savethechicken/foot-pedal/README.md

# USB Foot Pedal

A 3D-printable USB foot pedal powered by a Raspberry Pi Pico. It plugs in like a keyboard and sends whatever keys you choose, from a single key like **F13** to combos like **Ctrl+Shift+F13**. Change the keys any time with the **Pedal Config** app, with no code editing.

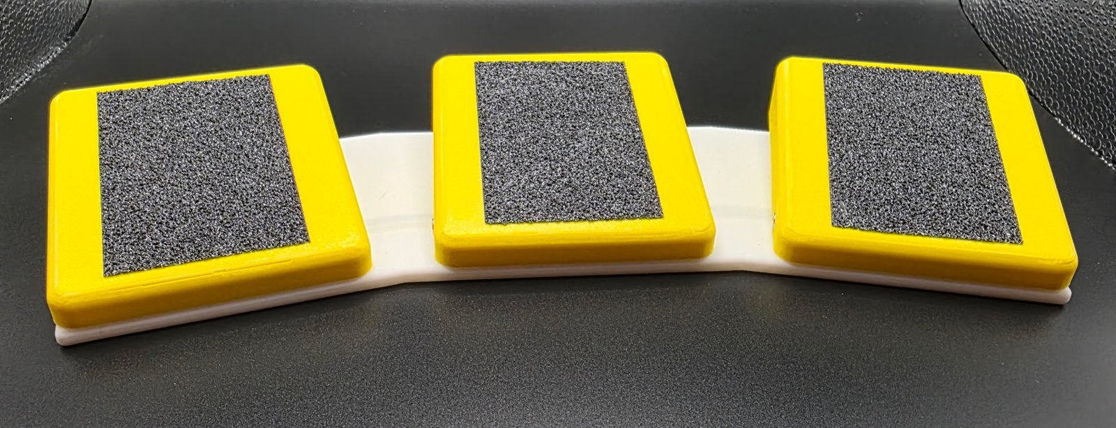
[picture p1: images/finished-front.jpg]
Finished three-pedal unit


- **Three-pedal version** (single-pedal version coming soon)
- **No supports needed.** Every printed part prints without supports.
- **Works on any computer** as a standard USB keyboard. The app is only needed to change keys.
- Mechanical key switch inside each pedal, with real metal springs for a solid feel

Inspired by the [USB Foot Switch](https://makerworld.com/en/models/2042179-usb-foot-switch#profileId-2203328) on MakerWorld. This is a complete redesign, not a remix, so **parts are not interchangeable** with the original.

---

## What's in this repo

| Folder | Contents |
|---|---|
| [`3d-print/`](3d-print) | Printable parts (`.3mf`) |
| [`firmware/`](firmware) | `boot.py` and `code.py` for the Pico (CircuitPython) |
| [`app/`](app) | Pedal Config app source (`pedal_config.py`) |
| [Releases](../../releases) | **Pedal Config.exe**, ready to run on Windows |
| [`docs/build-notes.md`](docs/build-notes.md) | My full build log: spring testing, print settings, code history |

---

## Materials

| Item | Single | Three | Notes |
|---|---|---|---|
| Raspberry Pi Pico 1 or 2 | 1 | 1 | |
| Cherry MX–style mechanical key switch | 1 | 3 | I used **Cherry MX Blue**: "clicky" switches that give a satisfying audible click with each press, so you know the pedal registered. Any MX-style switch fits. Pick a quieter type (Red, Brown) if the click would bother you or others nearby, like on a stream or call |
| Compression spring, 3/8" × 3/4" (≈9.5 × 19.1 mm) | 2 | 6 | From the [Harbor Freight 200-piece assorted spring set](https://www.harborfreight.com/200-piece-assorted-spring-set-67562.html), which includes 10 of this size. 7/32" × 11/16" and 3/8" × 5/8" from the same set also work |
| M3 heat-set inserts | 2 | 6 | Recommended. Screws alone also work (see Assembly) |
| M3 × 4 screws | 2 | 6 | M3 × 5 or M3 × 6 also work but are harder to tighten in the tight gap |
| M2 self-tapping screws | up to 4 | up to 4 | Optional, to mount the Pico. Hot glue works too |
| 22 AWG wire | ✓ | ✓ | Any color |
| Wago 221 lever connectors (2-port) | – | 2 | For the shared ground. Soldering the grounds together works too |
| Superglue and/or hot glue | optional | optional | Holds wire runs and the Pico in place |

> **Why not printed springs?** I tested several printable spring designs. Results were hit and miss, and 3 out of 5 failed before they could be used. Cheap metal springs are much more reliable.

---

## Printing

| Setting | Value |
|---|---|
| Material | PLA or PETG (both tested) |
| Supports | **None** |
| Layer height | 0.20 mm |
| Wall loops | 2 |
| Infill | 15% |

| File | Qty (three pedal) |
|---|---|
| `3d-print/three-pedal/TripleBaseV1.3mf` | 1 |
| `3d-print/pedals/Pedal_CutOut.3mf` | 1, the far-left pedal over the Pico (cutout for the USB port) |
| `3d-print/pedals/Pedal_NoCutOut.3mf` | 2, the middle and right pedals |

**Ready-to-print projects** (everything on two plates, settings included):

| Printer | File | Base |
|---|---|---|
| 270 × 270 mm bed or larger (made on a Snapmaker U1) | `3d-print/3_Pedal_Foot_Pedal_270mm_one-piece.3mf` | One piece |
| Bambu P1S, X1C or A1 (256 mm bed) | `3d-print/3_Pedal_Foot_Pedal_P1S_split.3mf` | Two halves with alignment dowels; glue them together as described below |

⚠️ **The three-pedal base needs a bed of at least 270 × 270 mm** to print in one piece (I used a Snapmaker U1). The pedals fit any printer. Print settings for Bambu Lab printers are in the [build notes](docs/build-notes.md#print-settings).

### Smaller printer? Split the base

For Bambu 256 mm printers, the **pre-split project above** is already done for you. For other printers, Bambu Studio and Orca Slicer both have a **Cut** tool: split the base, print the halves, then glue or plastic-weld them back together.

- **Cut through the flat section between two pedal housings,** not through a housing, the pivot posts, the screw holes or the wire channel.
- **Add alignment connectors when cutting.** The Cut tool's **Dowel** or **Plug** options help the halves line up straight, so the pedals sit level.
- **Test-fit the dowels first.** If they're tight, raise the Cut tool's connector tolerance slightly (often 0.1–0.2 mm).
- **Join with** superglue (CA), plastic cement, or a plastic weld (a soldering iron melting filament into the seam). Let it fully cure before assembly, since the base takes your foot's weight on every press.

---

## Wiring

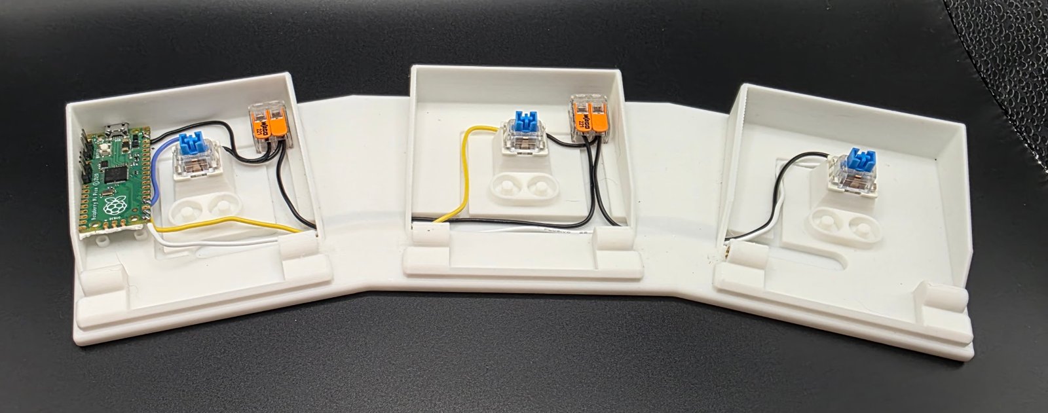
[picture p2: images/wiring-overview.jpg]
Wiring inside the three-pedal base


The Pico sits in the **far-left pedal** (as the unit sits on the floor in front of you), with its USB port facing out the side.

Each switch has two legs. One leg goes to its own Pico pin; the other goes to ground.

| Pedal | Pico pin | Physical pin # |
|---|---|---|
| Left | GP18 | 24 |
| Middle | GP17 | 22 |
| Right | GP16 | 21 |
| Ground (all switches) | GND | 38 (any GND pin works) |

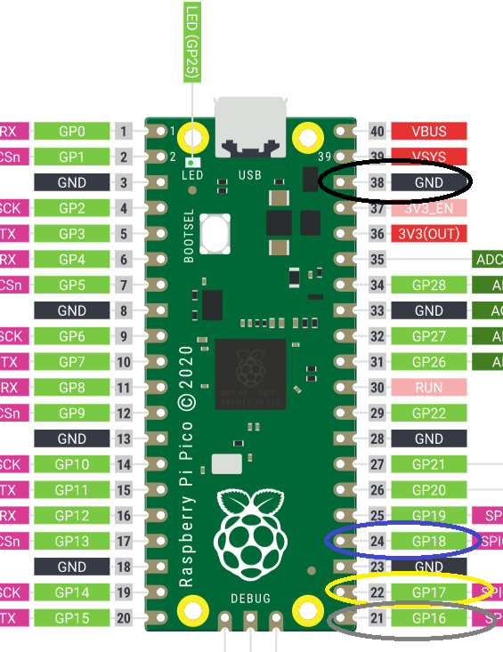
[picture p3: images/pico-pinout-pedal-pins.png]
Pico pinout with the pedal pins circled


*The pins used are circled. Note that the **GP** number (what the code uses) and the **physical pin number** (counted around the board) are different. Pinout diagram adapted from [Raspberry Pi Ltd](https://www.raspberrypi.com/documentation/microcontrollers/pico-series.html), CC BY-SA 4.0.*

> **Using different pins?** Any of the Pico's **GP** pins will work, but the firmware is set up for GP18, GP17 and GP16. If you wire to other pins, update the code to match, or those pedals won't respond:
>
> - **`code.py`:** the `PEDAL_PINS` line in the BUILD SETTINGS block, listed **left to right**. For example: `PEDAL_PINS = (board.GP2, board.GP3, board.GP4)`
> - **`boot.py`:** `SHOW_DRIVE_PIN`, the pedal you hold at plug-in to show the `CIRCUITPY` drive. It must be one of the pins in `PEDAL_PINS`.
>
> Ground can go to any **GND** pin.

**Ground:** Run one wire from a Pico **GND** pin to the switches. I daisy-chained it through two Wago connectors: the Pico's GND goes to Wago 1 in the left pedal, which feeds the left switch and continues to Wago 2 in the middle pedal, which feeds the middle and right switches. Where two thin wires share one Wago port, twist them together first. You can also solder the grounds together or use more than one of the Pico's GND pins.

No diodes are needed. Each pedal has its own pin, so there's no keyboard-matrix ghosting.

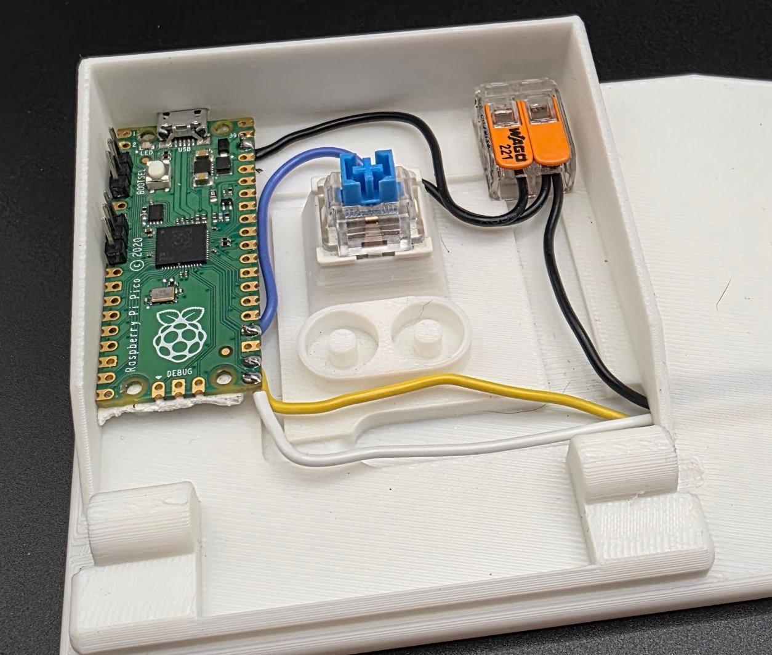
[picture p4: images/pico-closeup.jpg]
Pico close-up


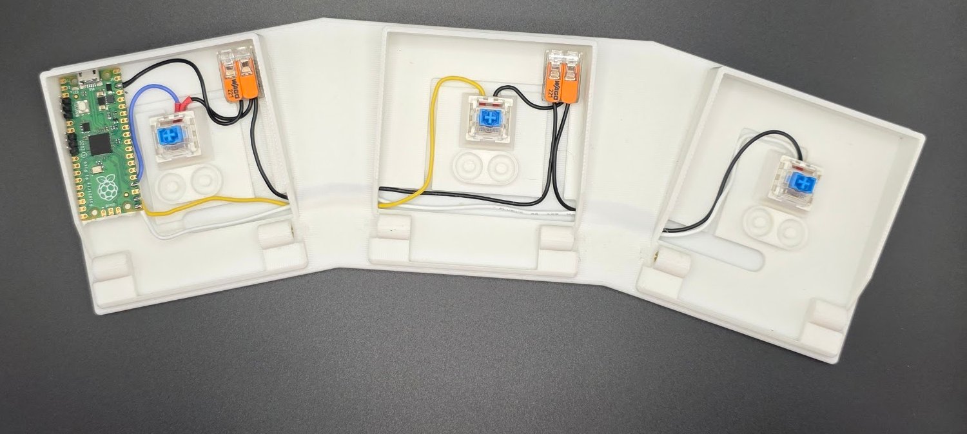
[picture p5: images/wiring-top.jpg]
Wiring, top view


---

## Assembly

1. **Heat-set inserts:** Install the M3 inserts. ⚠️ **Go slow.** There's no clear straight-on angle to the holes, but with patience they go in straight.

   > **Optional: skip the inserts.** In testing, the M3 screws also thread straight into the insert holes and hold the pedal in place with little to no play, while still letting it pivot correctly. Long-term durability without inserts hasn't been tested yet, so the inserts are still recommended. If you skip them and a pedal loosens over time, you can add inserts later.

2. **Pico:** Mount it with M2 self-tapping screws (the holes are sized at 1.8 mm), or hold it down with dots of hot glue at the corners. Keep glue off the USB port, the BOOTSEL button, and the solder joints.
3. **Switches and wiring:** Seat the switches, wire them as above, and glue the wire runs into their channels if you like.
4. **Springs:** Two per pedal, on the posts beside each switch.
5. **Pedals (three pedal):** Space between pedals is tight, so install in this order:
   1. **Middle pedal first:** with the outer pedals off, there's room for a driver on both screws.
   2. **Left and right pedals:** put in the **outside** screw first.
   3. **Inside screws:** reach into the gap with a small Allen wrench and turn a little at a time until flush on the inside.

   > ⚠️ **Don't over-tighten.** These screws are the pedal's hinge. Tighten them until they're snug, then check that the pedal still pivots freely and springs back up. If it binds, back the screws off slightly.

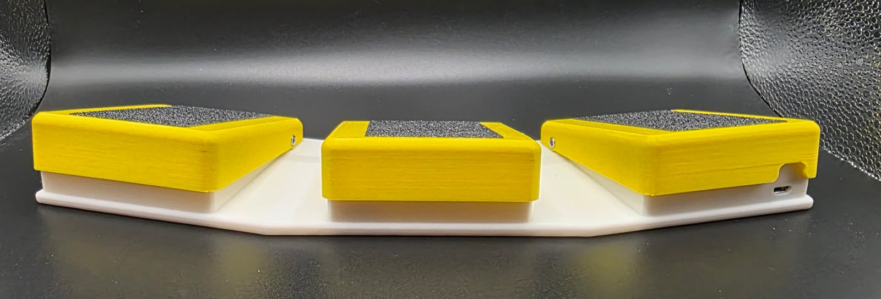
[picture p6: images/finished-side.jpg]
Side view


---

## Firmware

1. Install [CircuitPython](https://circuitpython.org/board/raspberry_pi_pico/) on the Pico ([Pico 2 page](https://circuitpython.org/board/raspberry_pi_pico2/)).
2. Download **`firmware.zip`** from [Releases](../../releases), unzip it, and copy everything inside (`boot.py`, `code.py`, and the `lib` folder) onto the `CIRCUITPY` drive. If the drive asks, replace the existing files. (The same files are in the [`firmware/`](firmware) folder of this repo.)
3. **Unplug and replug** the Pico.

When you're done, the drive should look like this:

```
CIRCUITPY/
├── boot.py
├── code.py
└── lib/
    └── adafruit_hid/
```

The only extra library needed, `adafruit_hid`, is included in `firmware/lib`. Everything else the code uses is built into CircuitPython. (If you prefer to get it yourself, it's in the official [CircuitPython library bundle](https://circuitpython.org/libraries).)

Default keys: **Left = F13, Middle = F14, Right = F15.** F13–F24 don't exist on normal keyboards, so they never clash with typing. Map them in Stream Deck, AutoHotkey, OBS, or any app that accepts hotkeys.

**Single pedal:** in `code.py`, swap the BUILD SETTINGS lines for the single-pedal ones (GP16), and in `boot.py` set `SHOW_DRIVE_PIN = board.GP16`.

### Editing the files later

`boot.py` hides the `CIRCUITPY` drive so the pedal acts like a plain keyboard. To show the drive, **hold the far-left pedal while plugging in.**

---

## Pedal Config app

Change each pedal's key or combo without touching code. Keys are saved on the Pico itself, so they stay set after unplugging and work on any computer.

### Option 1: download the `.exe` (Windows, easiest)

**No Python needed.** Everything the app needs is built into the `.exe`.

Download **Pedal Config.exe** from [Releases](../../releases) and run it. If Windows Defender warns about an unknown app, choose **More info → Run anyway**.

### Option 2: run from source (Windows, macOS, Linux)

**Requires Python 3.9 or newer** ([python.org](https://www.python.org/downloads/)). Use this option on macOS or Linux, or if you'd rather run the code directly.

```
py -m pip install pyserial
py app/pedal_config.py
```

On macOS or Linux, use `python3` in place of `py`.

### Using it

1. Plug in the pedal and open the app. It finds the pedal automatically.
2. For each pedal, tick any modifiers (Ctrl, Shift, Alt, Win) and pick a key.
3. Click **Save to Pedal**. The new keys work immediately.

Press a pedal and its dot in the app turns green, which is handy for checking your wiring.

<details>
<summary>How the app talks to the pedal</summary>

`boot.py` turns on a second USB serial port (`usb_cdc` data), separate from the normal CircuitPython console. The app sends one-line JSON commands over it:

| App sends | Pico replies |
|---|---|
| `{"cmd": "hello"}` | `{"ok": true, "device": "foot-pedal", "version": 1, "pedals": ["Left", "Middle", "Right"]}` |
| `{"cmd": "get"}` | `{"ok": true, "keys": [["F13"], ["F14"], ["F15"]]}` |
| `{"cmd": "set", "keys": [["CONTROL", "SHIFT", "F13"], ["F14"], ["A"]]}` | `{"ok": true, ...}` |

The Pico also sends `{"event": "press", "pedal": 0}` and `"release"` events. Keys are stored in the Pico's NVM (non-volatile memory) and checked against the `Keycode` list before saving, so a bad setting can't break the pedal.

</details>

### Building the `.exe` yourself

```
py -m pip install pyserial pyinstaller
py -m PyInstaller --onefile --windowed --name "Pedal Config" app/pedal_config.py
```

The `.exe` is also built automatically by GitHub Actions whenever a new release is published.

---

## Credits

- Original inspiration: [USB Foot Switch](https://makerworld.com/en/models/2042179-usb-foot-switch#profileId-2203328) on MakerWorld
- Designed by [savethechicken](https://github.com/savethechicken)

## License

This project uses two licenses:

| What | License | In short |
|---|---|---|
| **3D models, photos, docs** (`3d-print/`, `images/`, `docs/`, this README) | [CC BY-NC-SA 4.0](LICENSE-MODELS) | Download, print, and remix freely with credit. **No selling** the files or prints. Remixes must use the same license |
| **Firmware and app** (`firmware/`, `app/`) | [MIT](LICENSE-CODE) | Use, modify, and share freely. Keep the copyright notice |

Want to sell prints? [Open an issue](../../issues) and ask.

**Pico pinout diagram** (`images/pico-pinout-pedal-pins.png`): adapted from Raspberry Pi Ltd's Pico pinout, licensed CC BY-SA 4.0, not the project license.

**Included third-party library:** [`adafruit_hid`](https://github.com/adafruit/Adafruit_CircuitPython_HID) by Adafruit Industries, MIT License (see `firmware/lib/adafruit_hid/LICENSE`).
