savethechicken/foot-pedal/3d-print/3_Pedal_Foot_Pedal_P1S_split.3mf

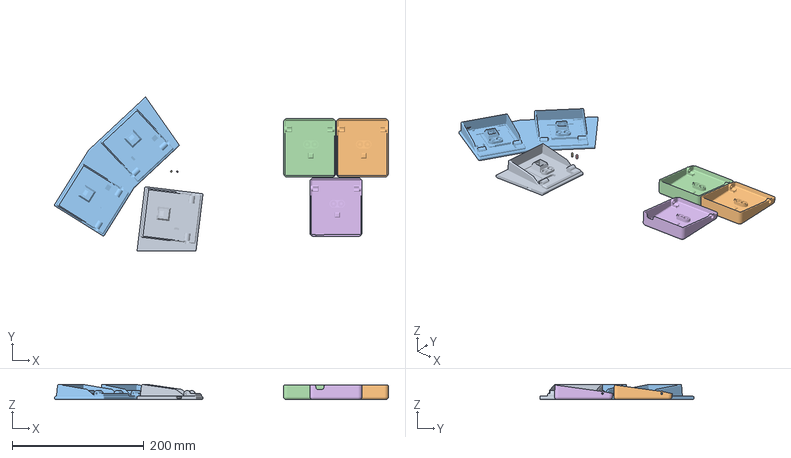
[picture p7: CAD file, 2026-10-11]
3d-print/3_Pedal_Foot_Pedal_P1S_split.3mf
507.0 x 233.9 x 22.8 mm
Base_Right
Pedal_NoCutOut x 2
Base_Left
Dowel-Connector-1
Pedal_CutOut
Dowel-Connector-2
