savethechicken/foot-pedal/3d-print/lids/Lid_NoCutOut.3mf

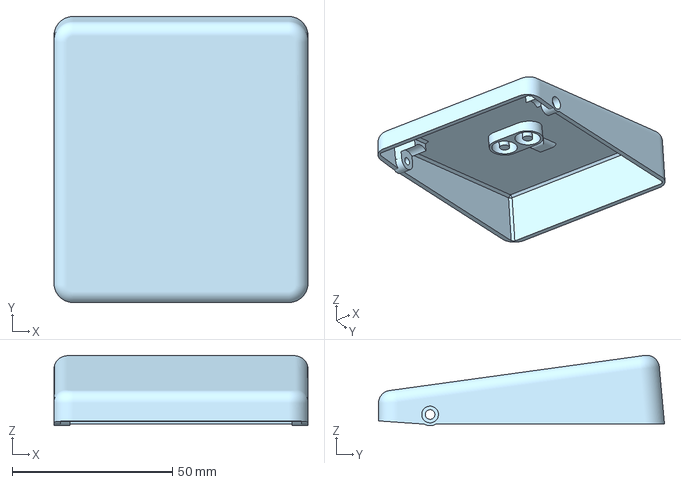
[picture p8: CAD file, 2026-10-10]
3d-print/lids/Lid_NoCutOut.3mf
79.2 x 89.2 x 22.0 mm
