savethechicken/foot-pedal/3d-print/three-pedal/TripleBaseV1.3mf

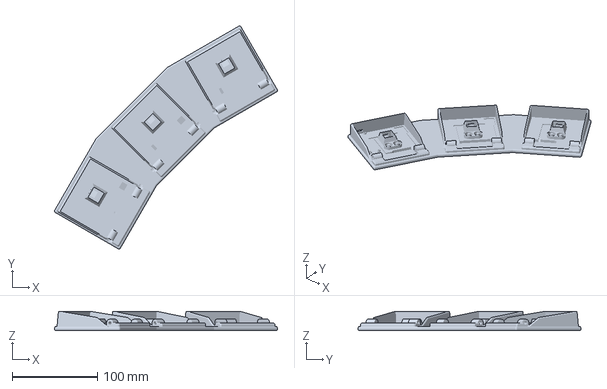
[picture p9: CAD file, 2026-10-10]
3d-print/three-pedal/TripleBaseV1.3mf
261.6 x 261.6 x 22.8 mm
