savethechicken/foot-pedal/(list of files, cad)

Other CAD files:
3d-print/pedals/Pedal_CutOut.3mf
