savethechicken/foot-pedal/(commit log)

2026-10-10 Initial release: three-pedal USB foot pedal
    3D print files, CircuitPython firmware with app-configurable keys,
    Pedal Config desktop app, and a GitHub Action that builds the .exe.
    Claude-Session: https://claude.ai/code/session_01XsgsS7J5NV1cMP7Jyktj3K
2026-10-10 Assembly: don't over-tighten the pedal pivot screws
    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
2026-10-10 Release build: also attach firmware.zip
    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
2026-10-10 Assembly: heat-set inserts are optional (screws alone tested)
    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
2026-10-10 Materials: note Cherry MX Blue (clicky) switches
    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
2026-10-10 Wiring: add Pico pinout with pedal pins circled
    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
2026-10-10 Wiring: explain how to use different GPIO pins
    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
2026-10-11 README: base needs a 270 x 270 mm bed; how to split it for smaller printers
    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
2026-10-11 P1S split project: rename objects (Base_Left/Right, Pedal_CutOut/NoCutOut, Dowel-Connector)
    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
2026-10-11 Add one-piece 270 mm project (Snapmaker U1) and list both ready-to-print projects
    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
2026-10-11 270 mm project: standard print preset
    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
2026-10-11 270 mm project: generic filament presets
    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
